NessieCircuits/Riotee_SensorShield/README.md

# Riotee Sensor Shield Hardware Design Files



The Riotee Sensor Shield adds a microphone, an accelerometer and a temperature and humidty sensor to the [Riotee Board](https://github.com/NessieCircuits/Riotee_Board).

Latest design files:
 - [Schematics](https://www.riotee.nessie-circuits.de/artifacts/sensor_shield/latest/schematics.pdf)
 - [Layout](https://www.riotee.nessie-circuits.de/artifacts/sensor_shield/latest/pcb.pdf)
 - [3D rendering](https://www.riotee.nessie-circuits.de/artifacts/sensor_shield/latest/3drendering.png)
 - [Gerber](https://www.riotee.nessie-circuits.de/artifacts/sensor_shield/latest/gerber.zip)
 - [BOM](https://www.riotee.nessie-circuits.de/artifacts/sensor_shield/latest/bom.csv)

Rendering of Riotee sensor shield Riotee sensor shield

## Sensors

The shield is equipped with the following sensors:
 - Bosch BMA400 digital accelerometer
 - Sensirion SHTC3 temperature and humidity sensor
 - Vesper VM1010 analog output microphone
