NessieCircuits/Riotee_SensorShield/(commit log)

2023-01-19 update kicad library
    [riotee-sensor-shield.kicad_pcb]
2023-02-09 switch to stacking header 3d models
    [riotee-sensor-shield.kicad_pcb]
2023-02-20 add MPNs in schematics
    [riotee-sensor-shield.kicad_sch]
2023-04-10 minor layout optimizations
    [riotee-sensor-shield.kicad_pcb]
2023-04-10 replace 0R resistors with solder bridges
    [riotee-sensor-shield.kicad_pcb, riotee-sensor-shield.kicad_sch]
2023-04-12 add bias reference for VM1010 microphone
    [riotee-sensor-shield.kicad_pcb, riotee-sensor-shield.kicad_sch]
2023-04-12 add optional capacitor footprint and pullup for microphone mode
    [riotee-sensor-shield.kicad_pcb, riotee-sensor-shield.kicad_sch]
2023-04-13 add conformity marks to bottom silkscreen
    [riotee-sensor-shield.kicad_pcb, riotee-sensor-shield.kicad_sch]
2023-04-14 refine BOM
    [riotee-sensor-shield.kicad_pcb, riotee-sensor-shield.kicad_sch]
2023-04-28 remove DNP pullup from microphone mode and fine-tune some footprints
    [riotee-sensor-shield.kicad_pcb, riotee-sensor-shield.kicad_sch]
2023-04-28 update kibot to kicad version 7
2024-06-26 update to kicad 8
    [riotee-sensor-shield.kicad_pcb, riotee-sensor-shield.kicad_sch]
2024-10-15 generate bom and gerber in github workflow with kibot
